PerryXu1/optical-power-meter/Block Diagram/opm-block-diagram.png

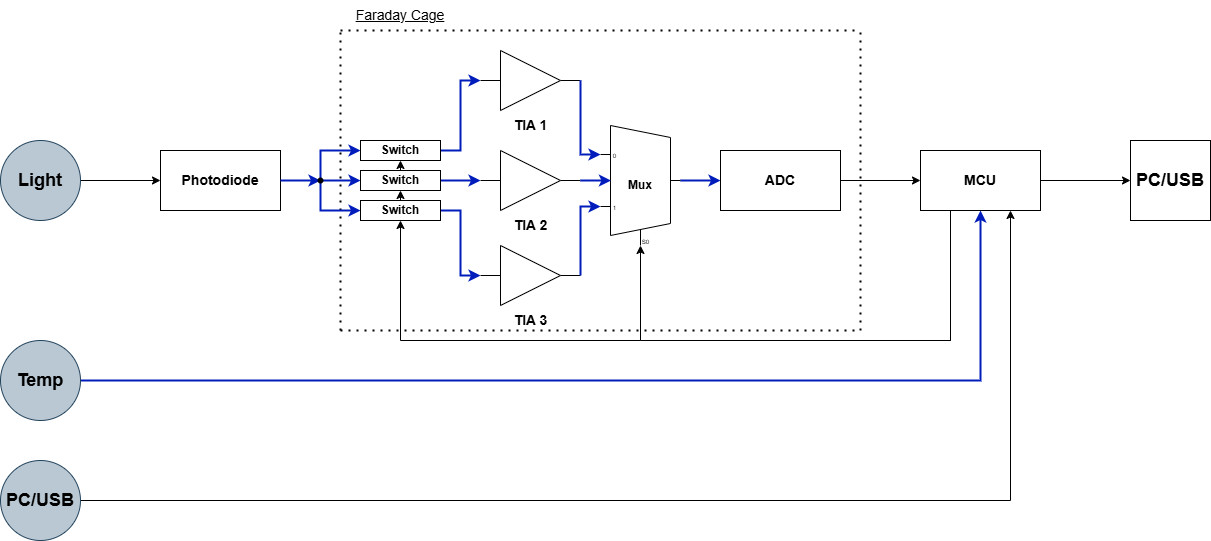
Block Diagram/opm-block-diagram.png
