PerryXu1/optical-power-meter/Hardware/Components/CC0603JRX7R8BB104/CC0603JRX7R8BB104.step

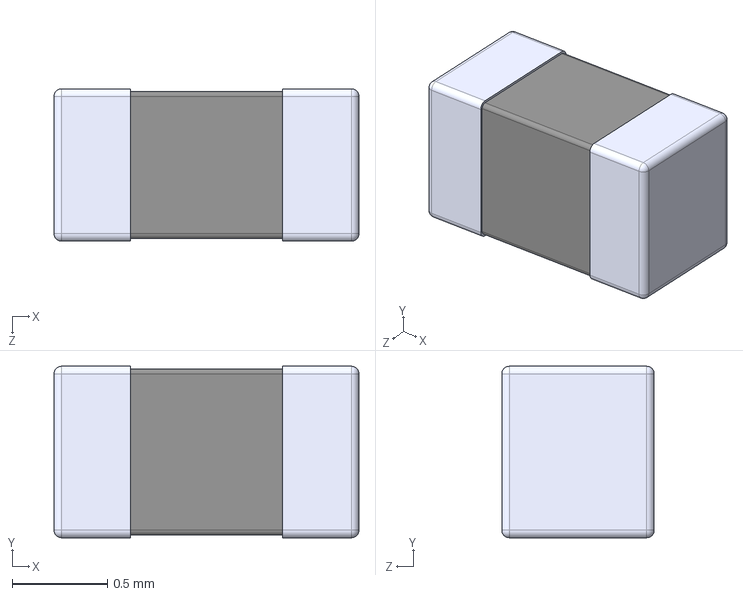
[picture p2: CAD file, 2026-03-04]
Hardware/Components/CC0603JRX7R8BB104/CC0603JRX7R8BB104.step
1.60 x 0.9 x 0.8 mm
