PerryXu1/optical-power-meter/Hardware/Components/CC0805KKX7R7BB106/Altium/CAP_CC0805_YAG.step

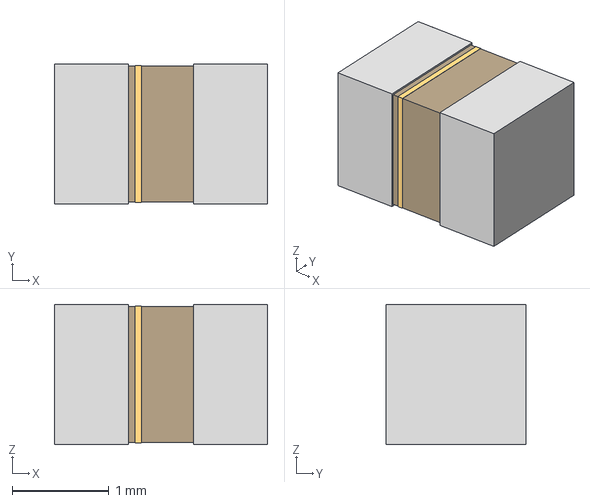
[picture p3: CAD file, 2026-03-04]
Hardware/Components/CC0805KKX7R7BB106/Altium/CAP_CC0805_YAG.step
2.20 x 1.45 x 1.45 mm
