PerryXu1/optical-power-meter/Hardware/Components/CRCW08051M00FKEA/CRCW08051M00FKEA.STEP

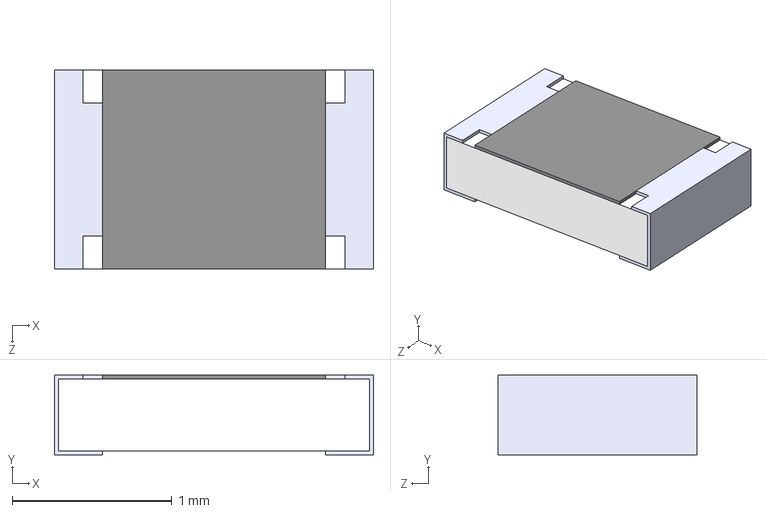
[picture p4: CAD file, 2026-03-12]
Hardware/Components/CRCW08051M00FKEA/CRCW08051M00FKEA.STEP
2.00 x 0.5 x 1.25 mm
