PerryXu1/optical-power-meter/Hardware/Components/LIB_104JT-025/104JT-025/3D/104JT-025.stp

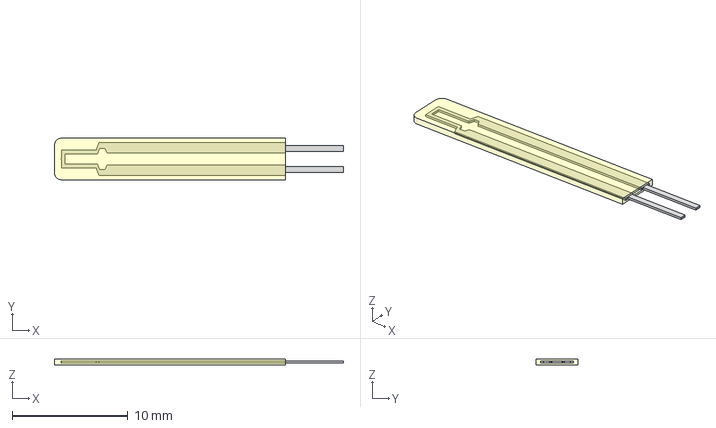
[picture p5: CAD file, 2026-03-04]
Hardware/Components/LIB_104JT-025/104JT-025/3D/104JT-025.stp
25.0 x 3.60 x 0.5 mm
