PerryXu1/optical-power-meter/Hardware/Components/OPA392DBVR/Altium/OPA392DBVR/SOT-23-5_DBV_TEX.step

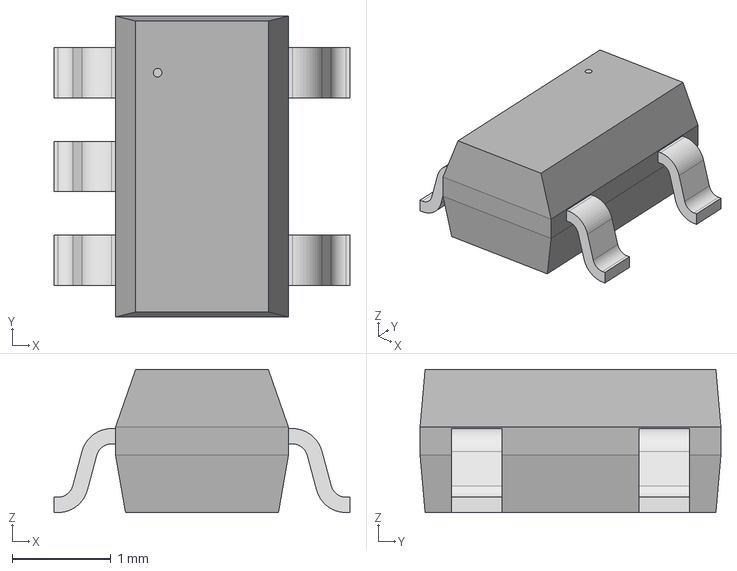
[picture p6: CAD file, 2026-03-04]
Hardware/Components/OPA392DBVR/Altium/OPA392DBVR/SOT-23-5_DBV_TEX.step
3.00 x 3.05 x 1.45 mm
