PerryXu1/optical-power-meter/Hardware/Components/OPA392DBVR/DBV0005A.stp

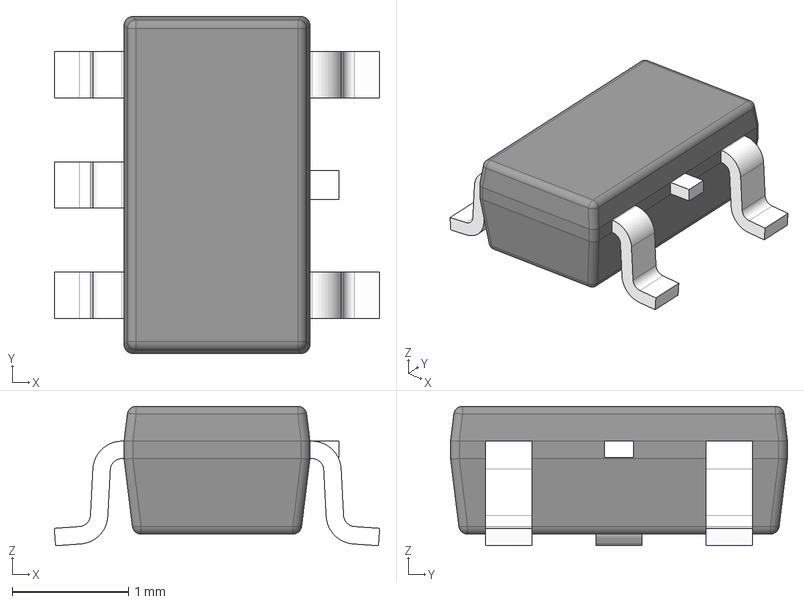
[picture p7: CAD file, 2026-03-04]
Hardware/Components/OPA392DBVR/DBV0005A.stp
2.80 x 2.90 x 1.20 mm
BODY-SOT
LEAD-SOT x 5
LEAD-DUMMY
