PerryXu1/optical-power-meter/Hardware/Components/SS12/SS12.STEP

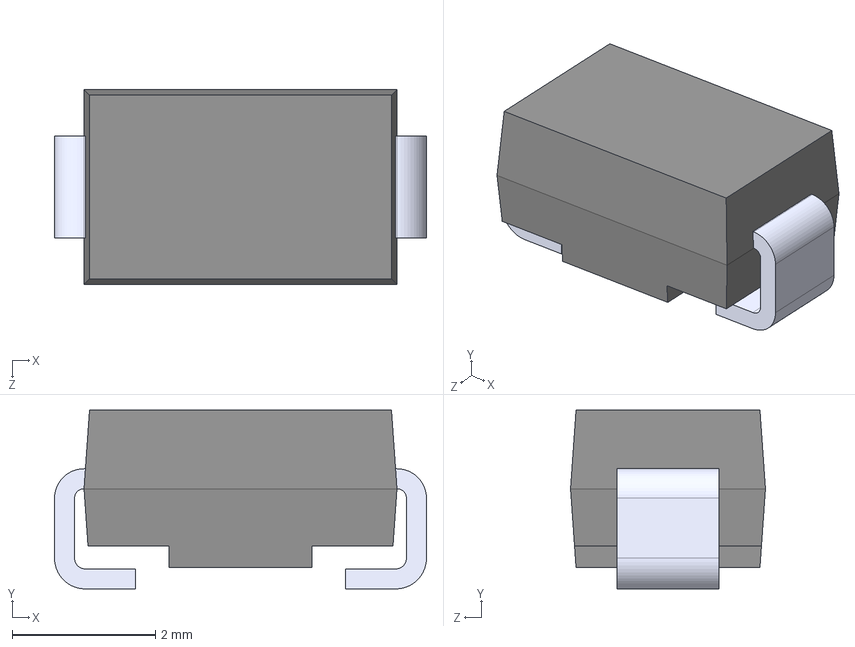
[picture p8: CAD file, 2026-03-04]
Hardware/Components/SS12/SS12.STEP
5.20 x 2.50 x 2.72 mm
