PerryXu1/optical-power-meter/Hardware/Components/TMUX1119DBVR/DBV0006A.stp

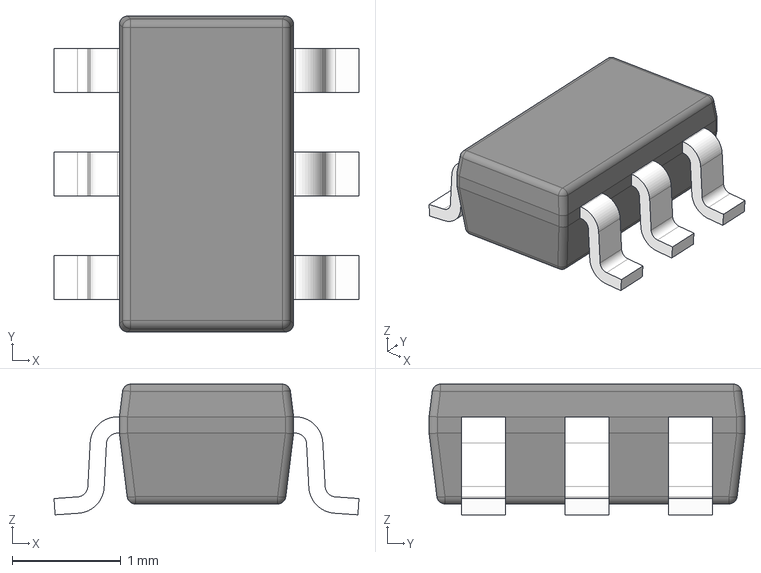
[picture p9: CAD file, 2026-03-04]
Hardware/Components/TMUX1119DBVR/DBV0006A.stp
2.80 x 2.90 x 1.20 mm
BODY-SOT
LEAD-SOT x 6
