PerryXu1/optical-power-meter/Hardware/Components/TNPW0603100KBXEN/TNPW0603100KBXEN.STEP

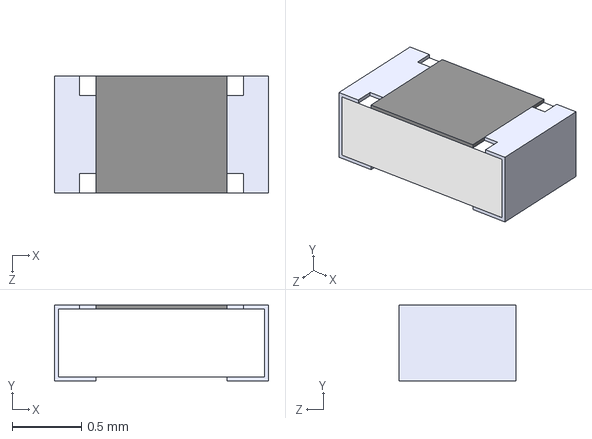
[picture p10: CAD file, 2026-03-04]
Hardware/Components/TNPW0603100KBXEN/TNPW0603100KBXEN.STEP
1.55 x 0.55 x 0.85 mm
