PerryXu1/optical-power-meter/Hardware/Components/TNPW080510K0BXEN/TNPW080510K0BXEN.STEP

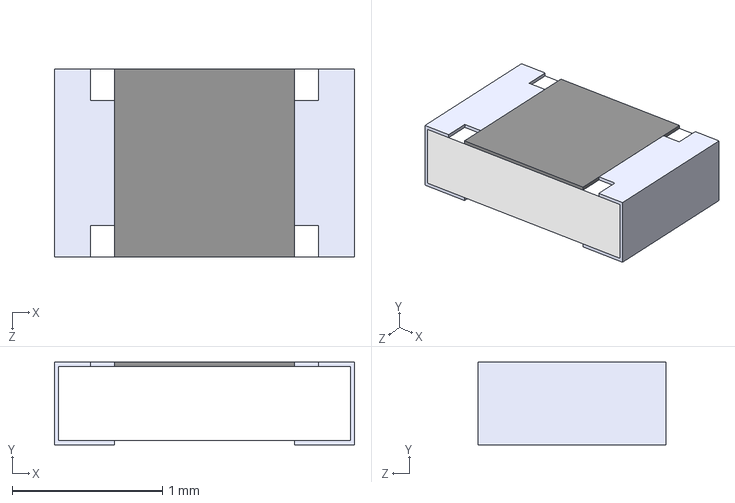
[picture p11: CAD file, 2026-03-04]
Hardware/Components/TNPW080510K0BXEN/TNPW080510K0BXEN.STEP
2.00 x 0.55 x 1.25 mm
