PerryXu1/optical-power-meter/Hardware/Components/VBPW34S/VBPW34S.STEP

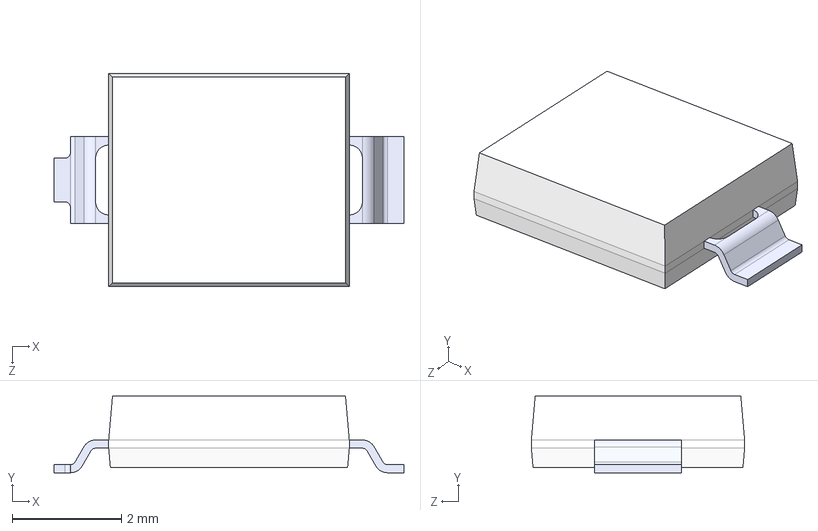
[picture p12: CAD file, 2026-03-04]
Hardware/Components/VBPW34S/VBPW34S.STEP
6.40 x 1.40 x 3.90 mm
