PerryXu1/optical-power-meter/Hardware/Components/VJ1206Y472KXEAT5Z/VJ1206Y472KXEAT5Z.STEP

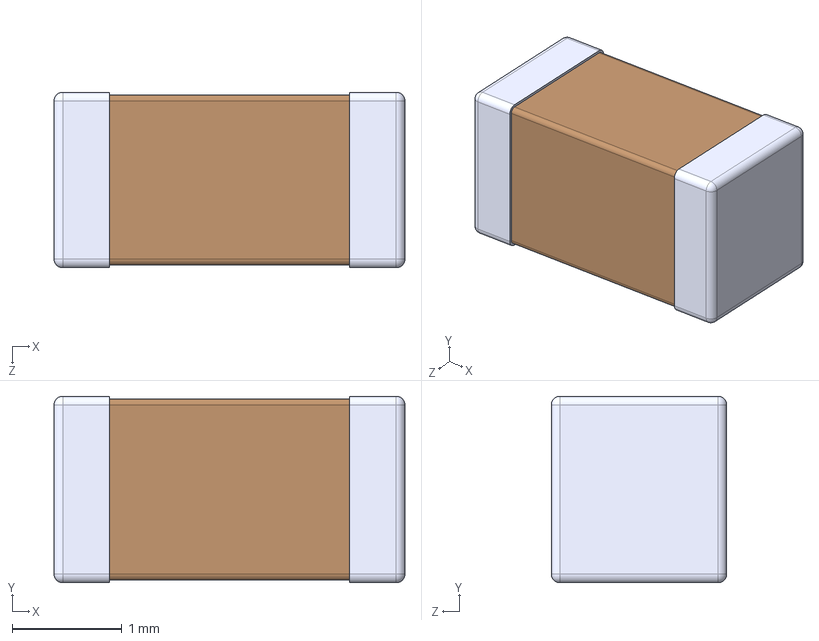
[picture p13: CAD file, 2026-03-12]
Hardware/Components/VJ1206Y472KXEAT5Z/VJ1206Y472KXEAT5Z.STEP
3.20 x 1.70 x 1.60 mm
