PerryXu1/optical-power-meter/Hardware/Components/MCP73831T_2ACI_OT/MCP73831T-2ACI_OT.STEP

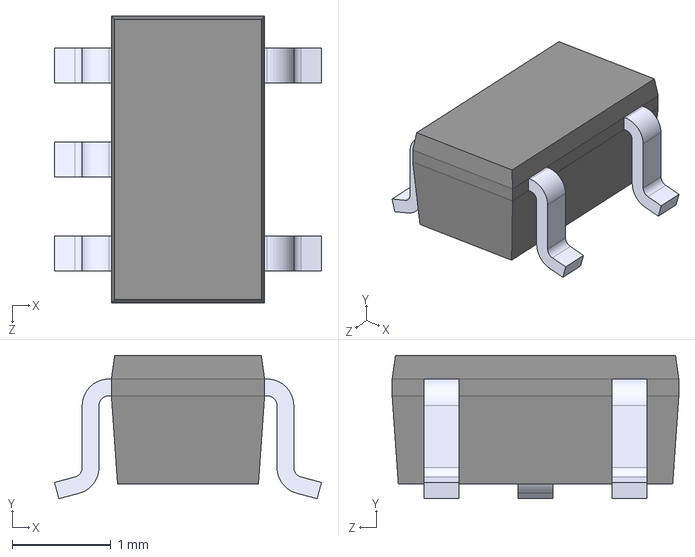
[picture p15: CAD file, 2026-03-04]
Hardware/Components/MCP73831T_2ACI_OT/MCP73831T-2ACI_OT.STEP
2.70 x 1.45 x 2.90 mm
