PerryXu1/optical-power-meter/(list of files, cad)

Other CAD files:
Hardware/Components/CC0805KKX7R7BB106/CAP_CC0805_YAG.step
Hardware/Components/TMUX1119DBVR/Altium/TMUX1119DBVR/SOT-23-6_DBV_TEX.step
Hardware/Components/LIB_104JT-025/104JT-025/Allegro/104jt025.psm
Hardware/Components/LIB_104JT-025/104JT-025/DEHDL/104jt_025/chips/chips.prt
