PerryXu1/optical-power-meter/Hardware/opm/opm.pdf

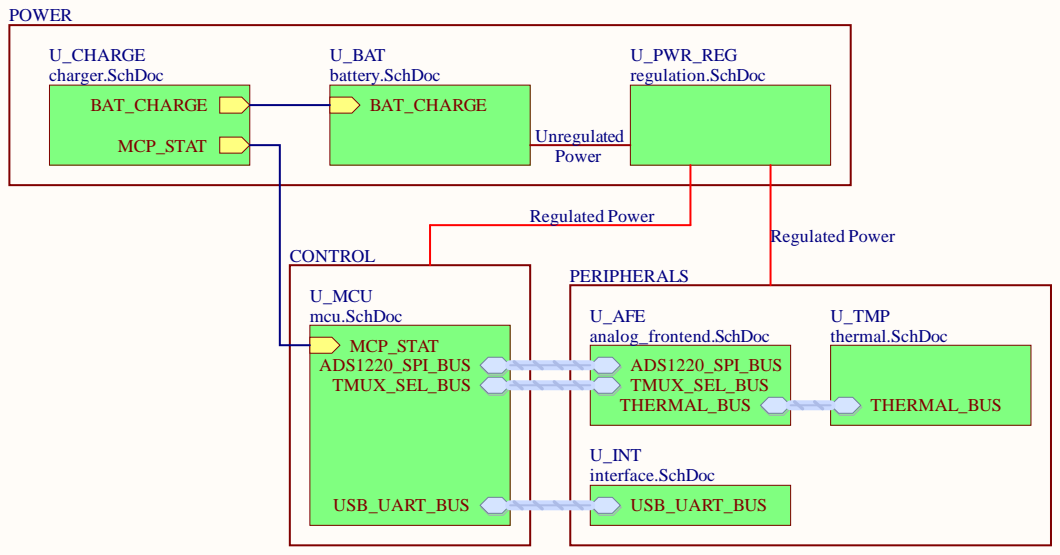
[picture p27: page 1]

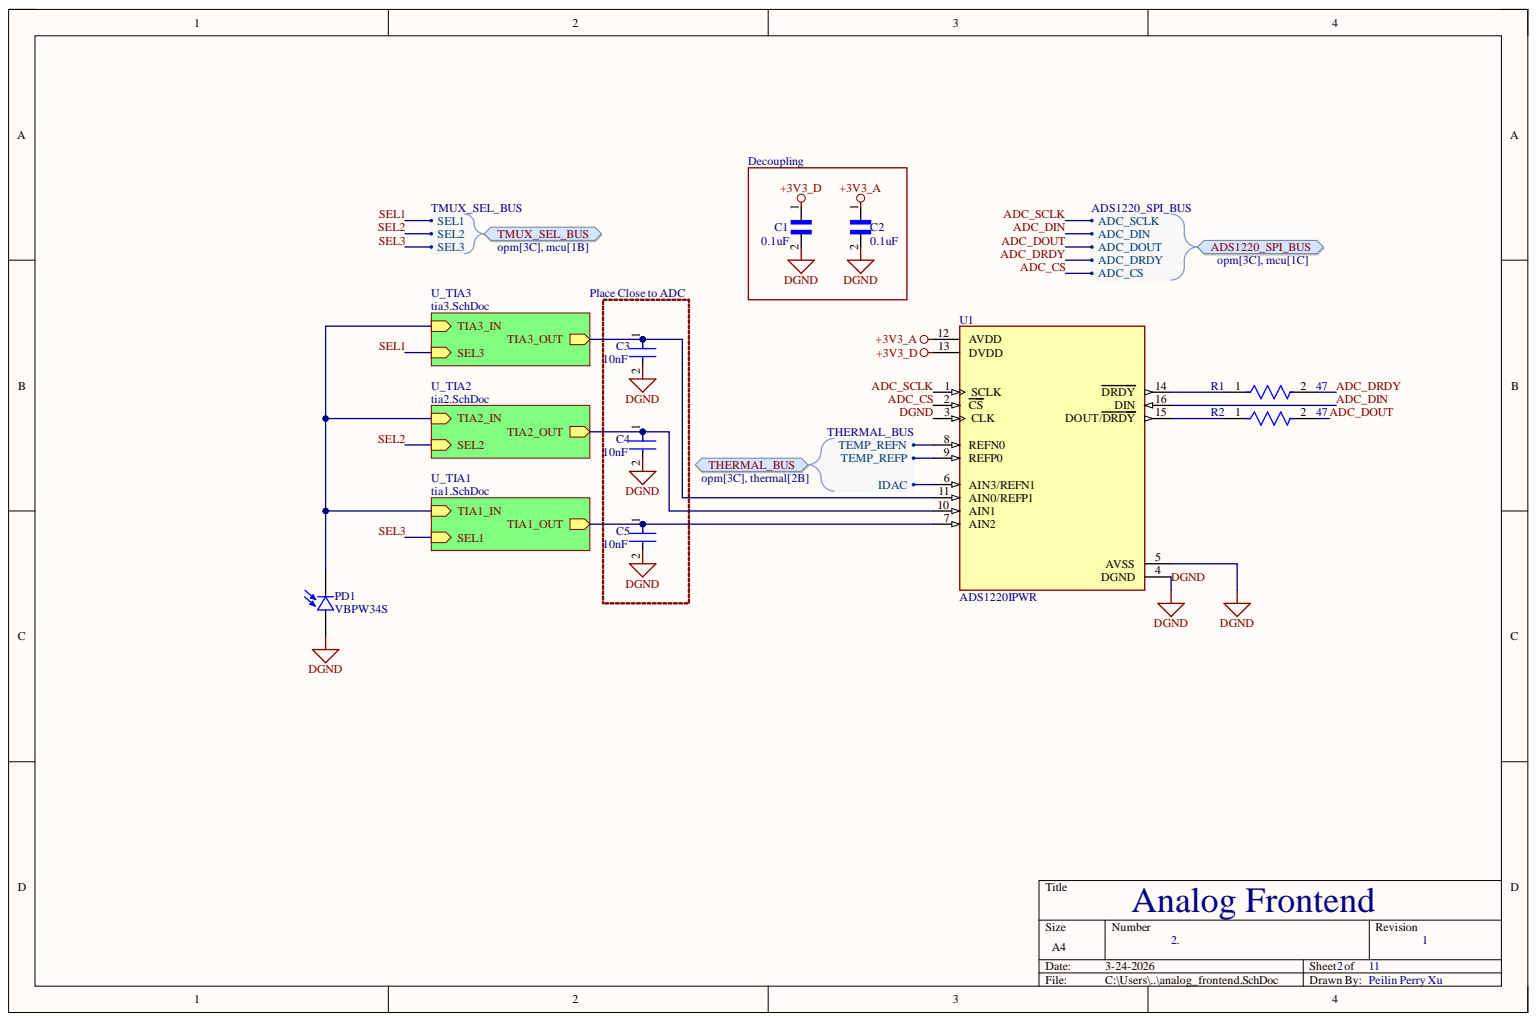
[picture p28: page 2]

Place Close to ADC

DGND | TEMP_REFN opm[3C], thermal[2B] IDAC

TIA1_IN TIA1_OUT SEL1 | | AIN1 10

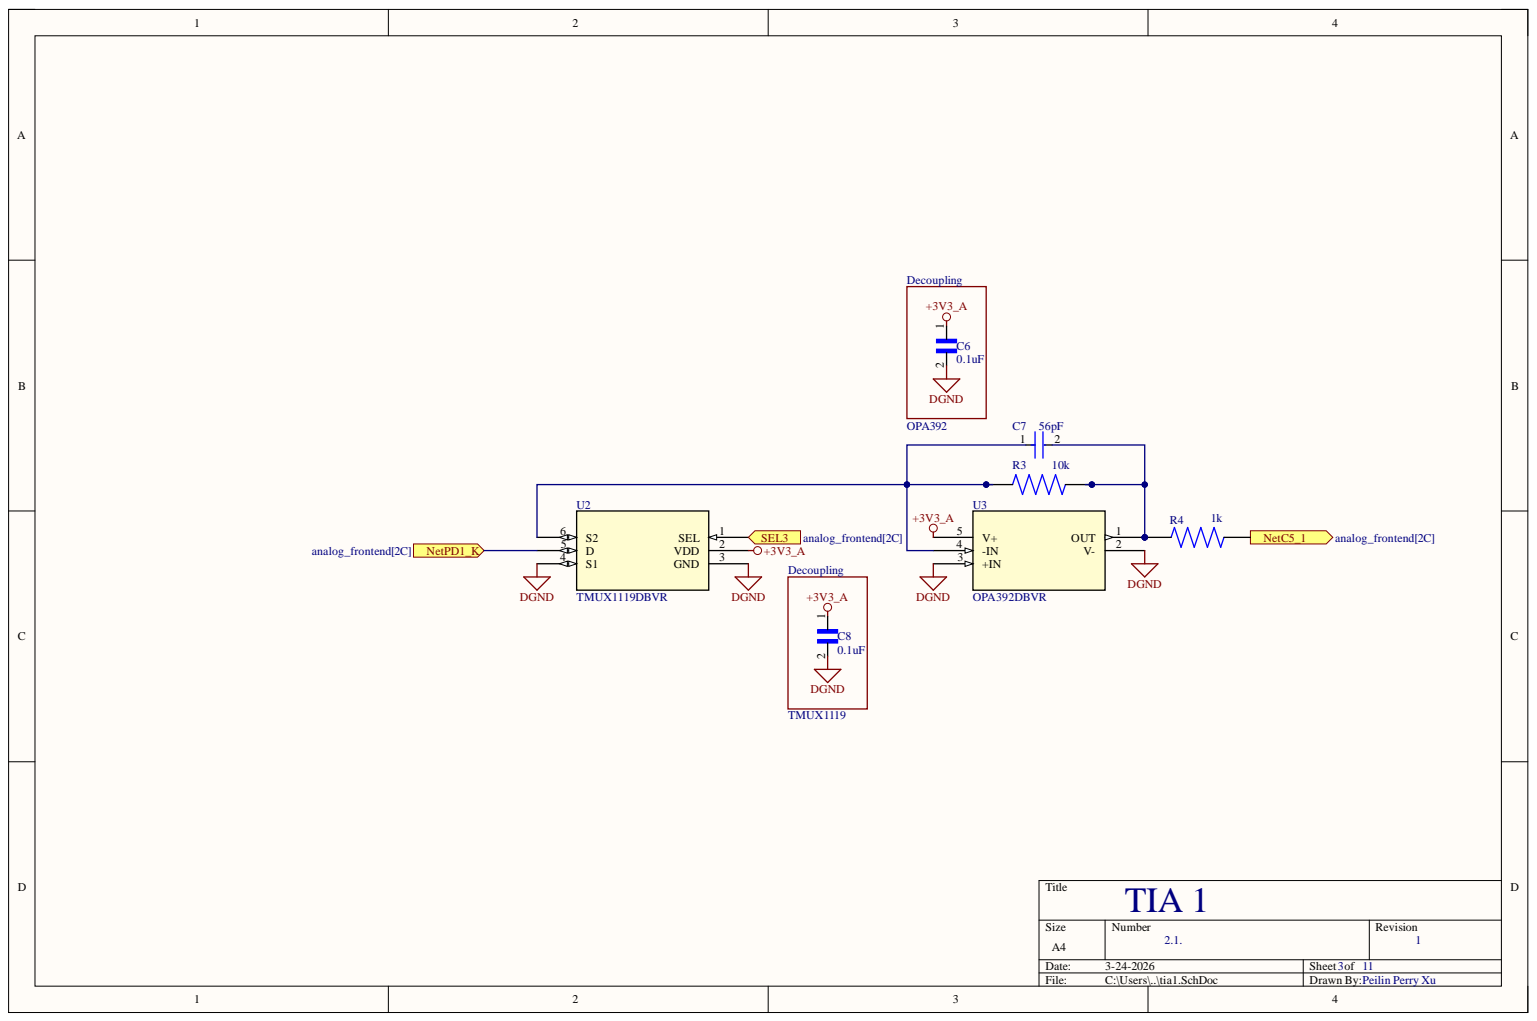
[picture p29: page 3]

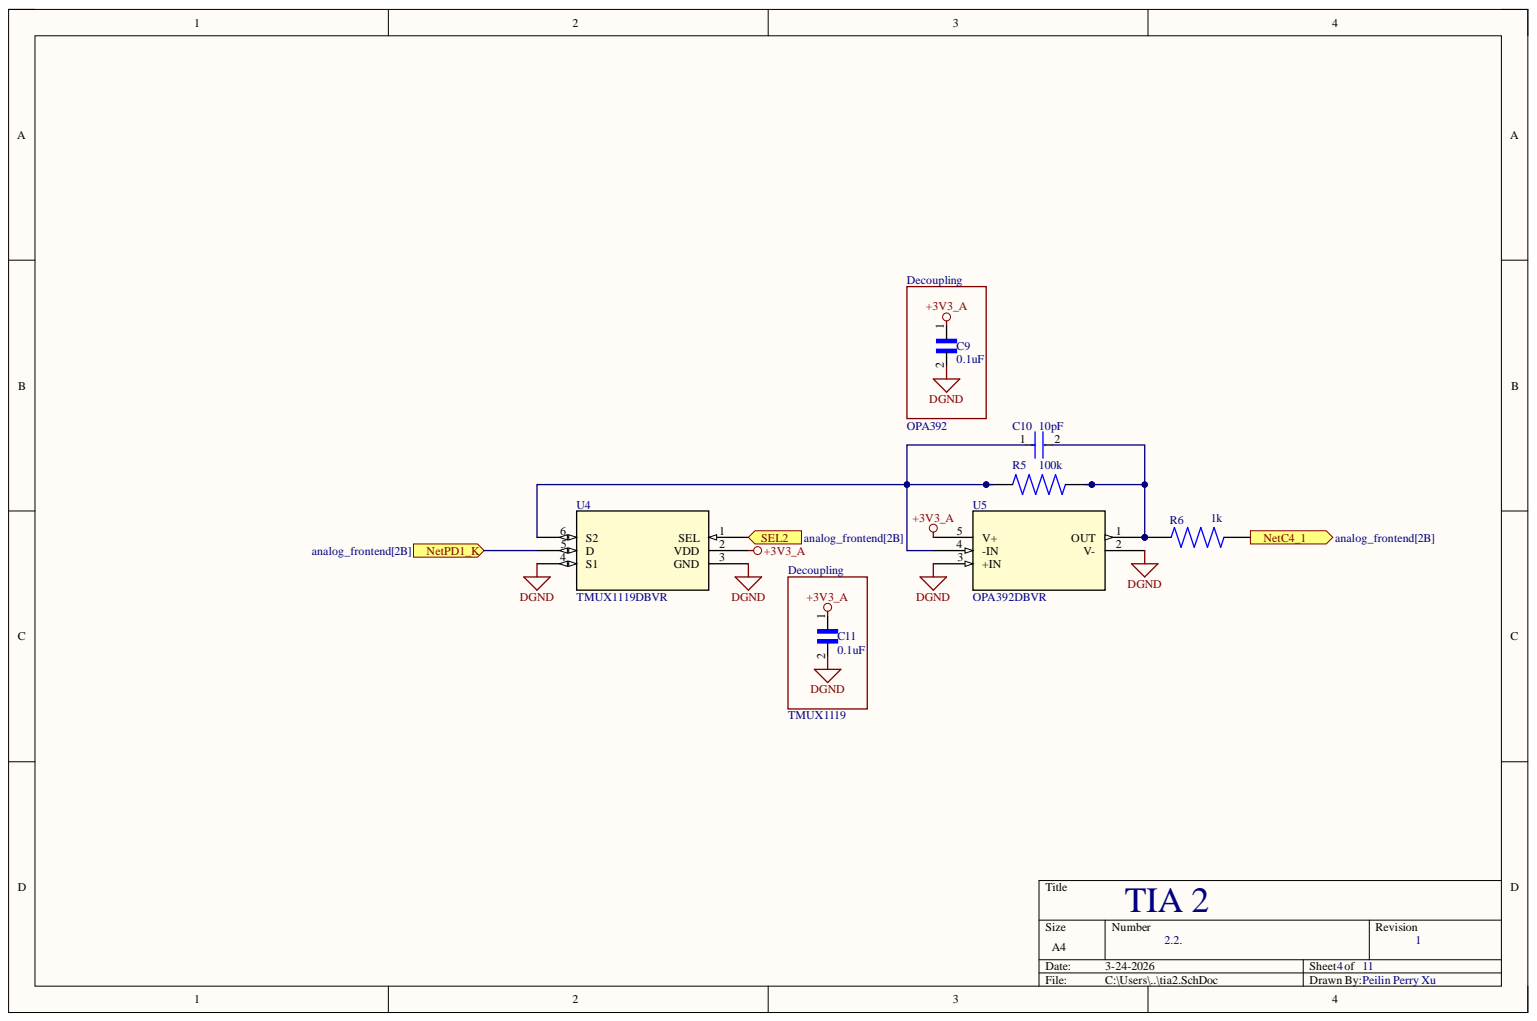
[picture p30: page 4]

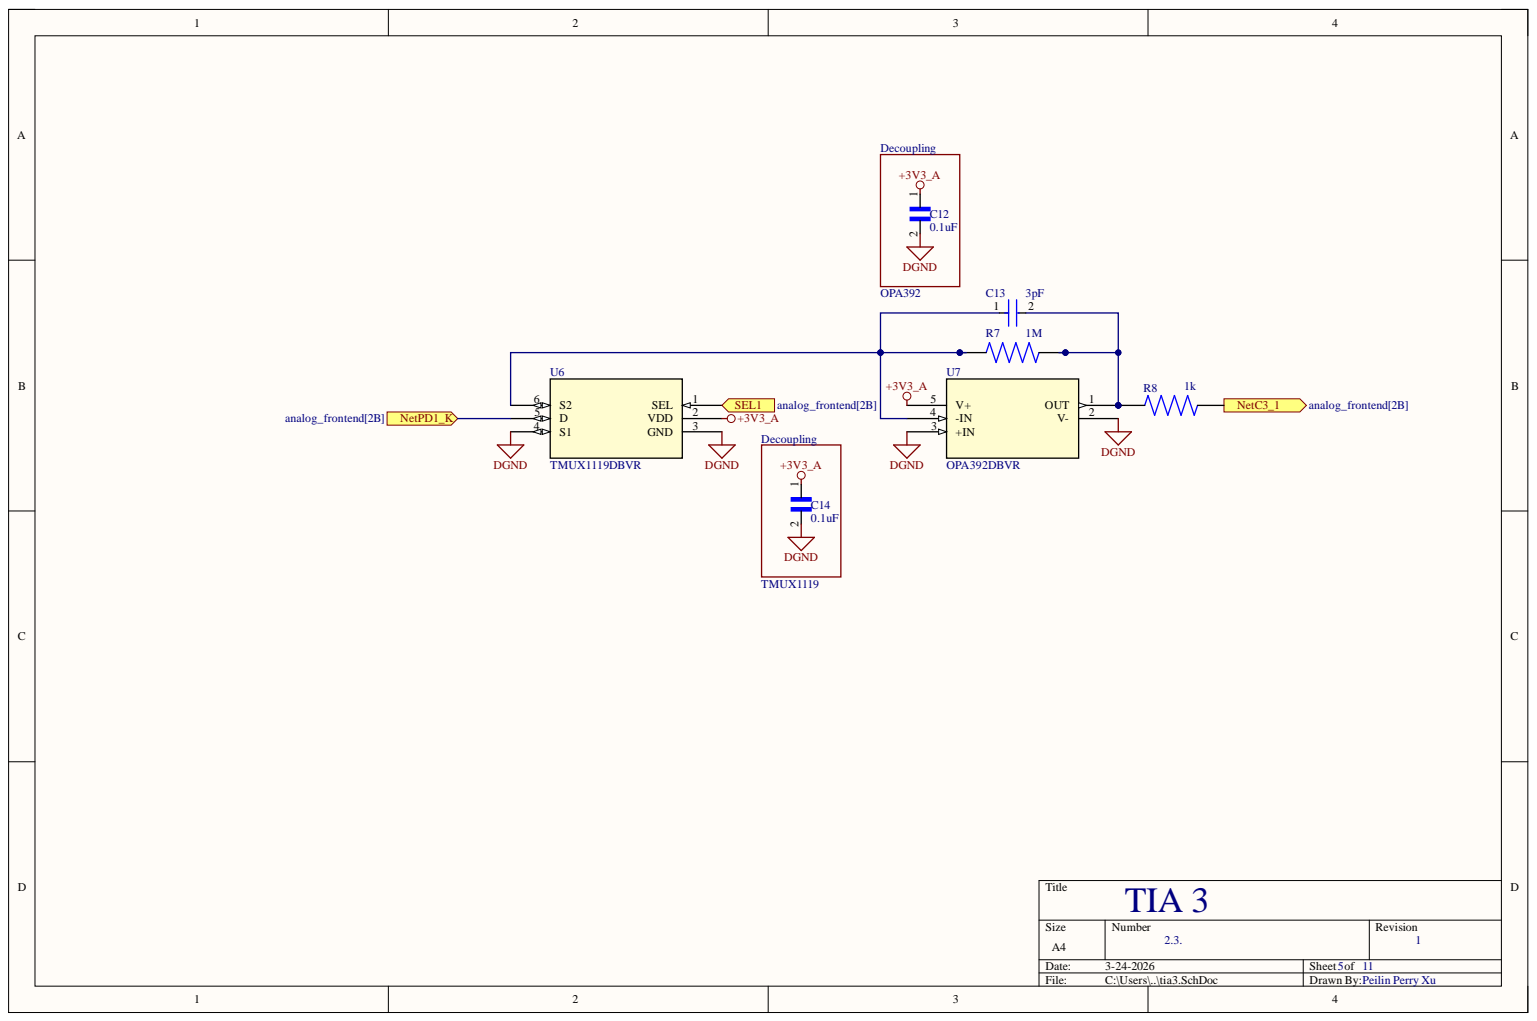
[picture p31: page 5]

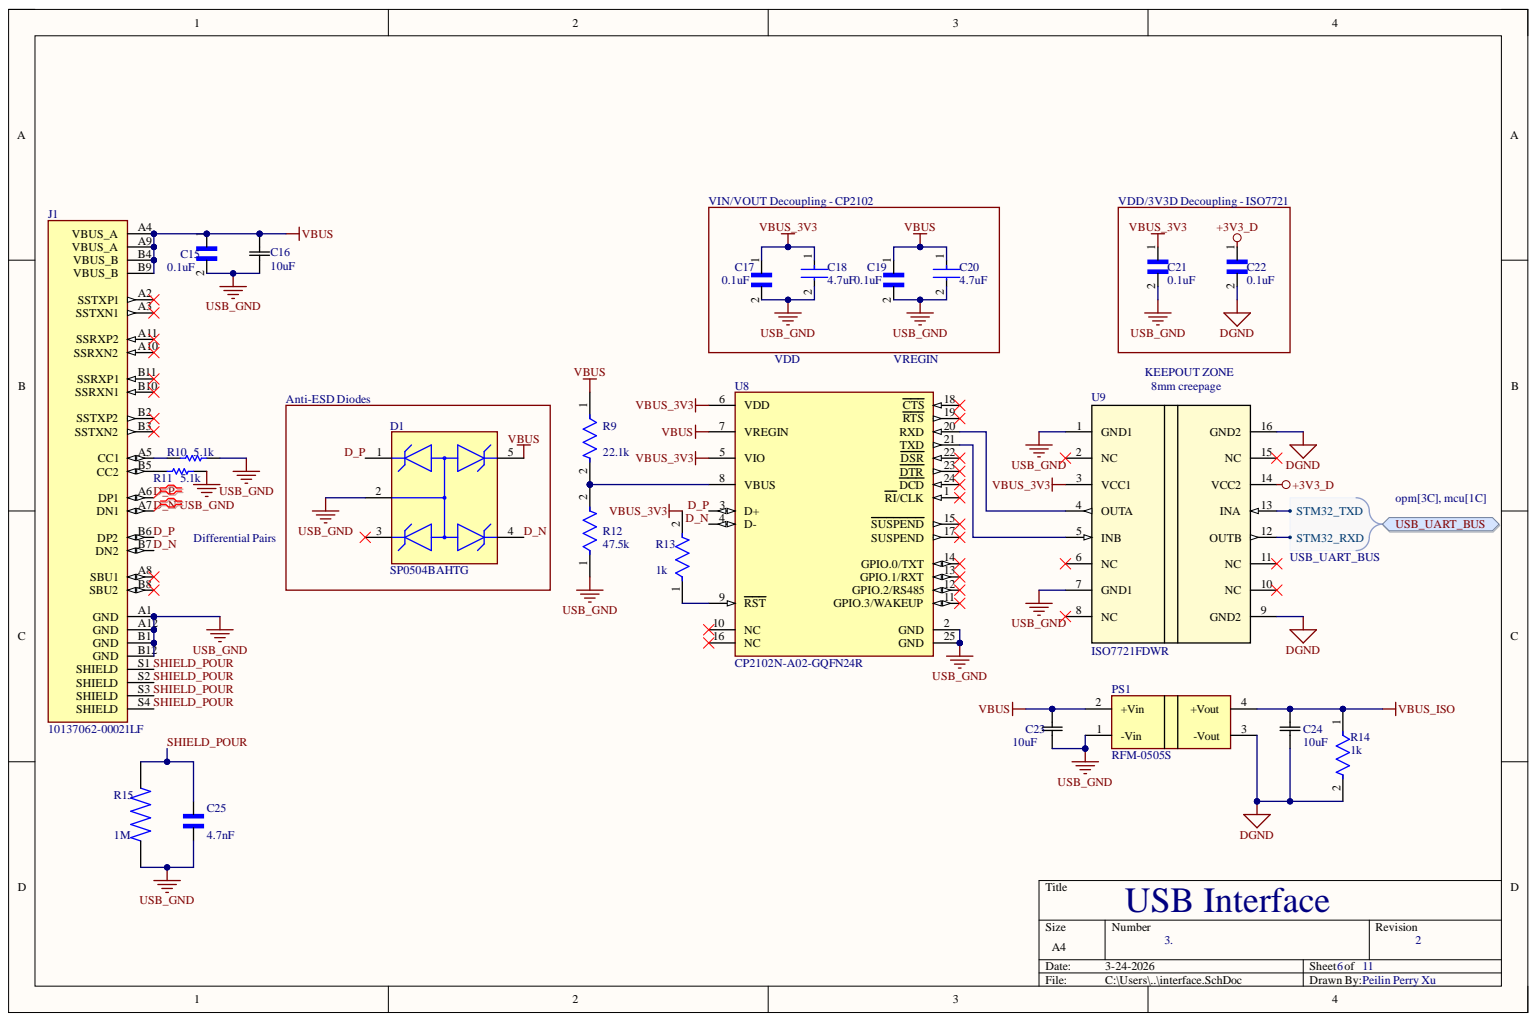
[picture p32: page 6]

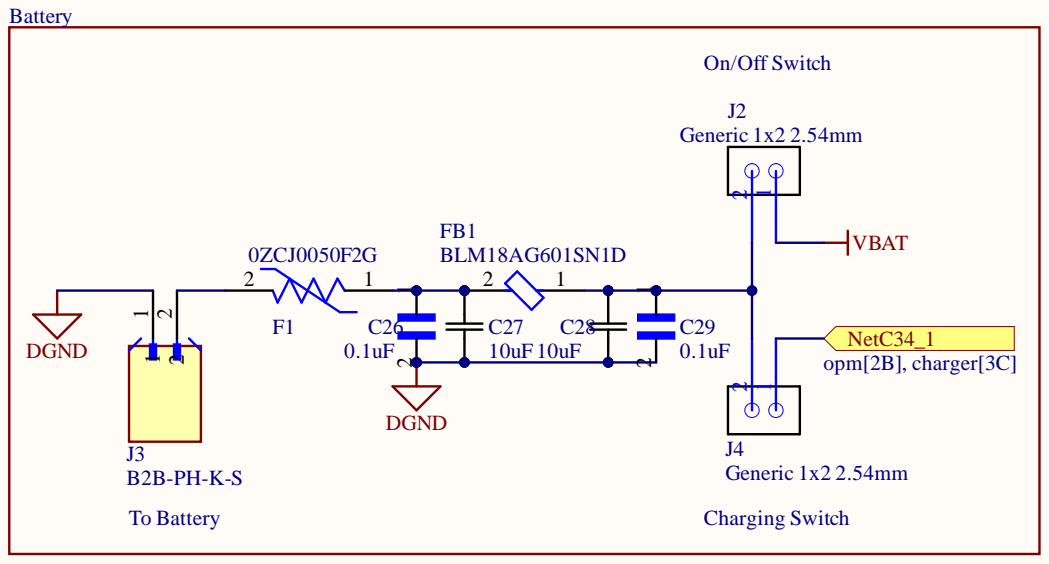
[picture p33: page 7]

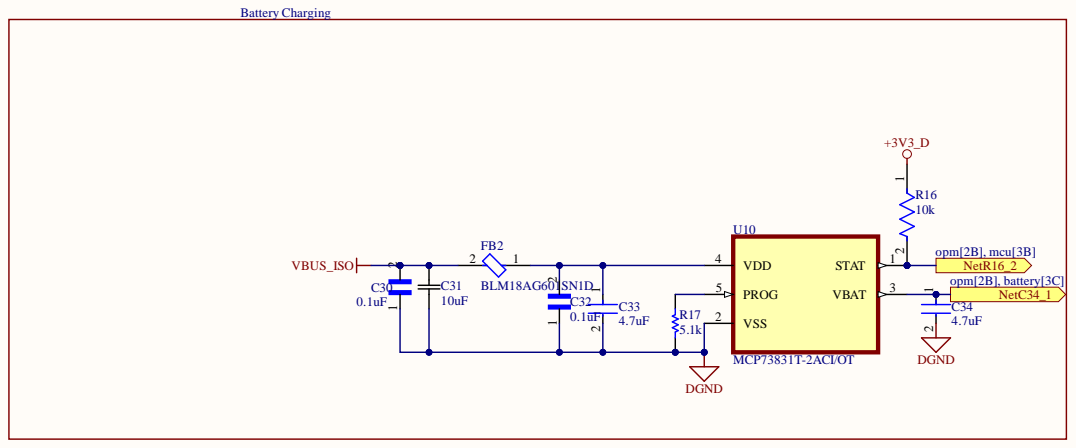
[picture p34: page 8]

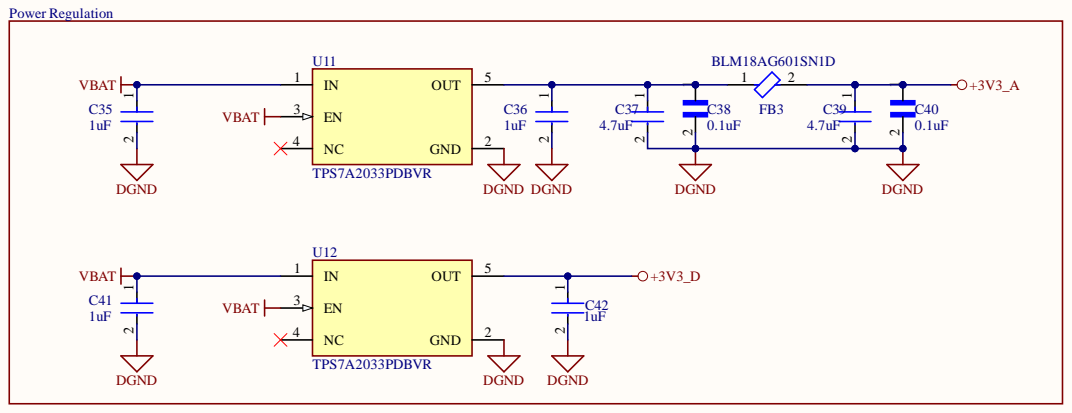
[picture p35: page 9]

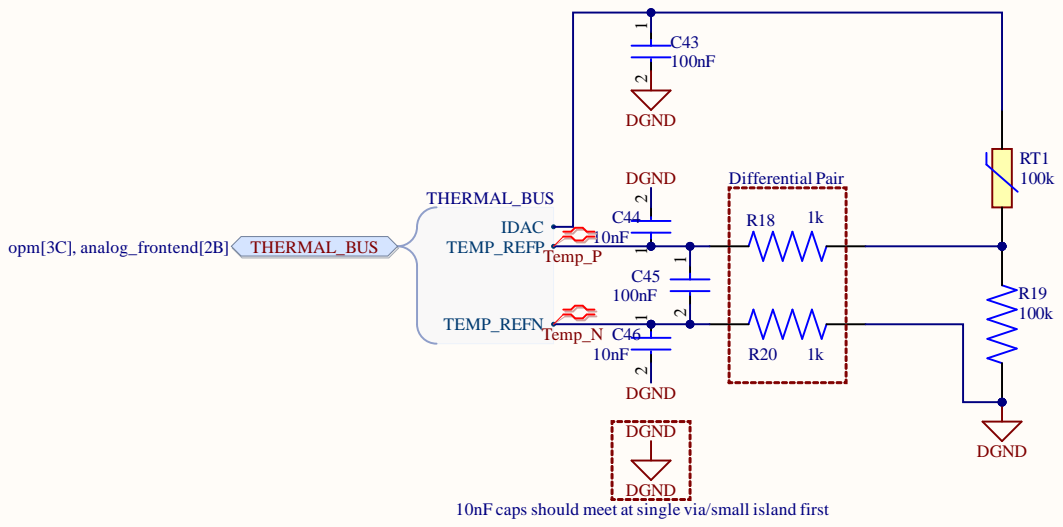
[picture p36: page 10]

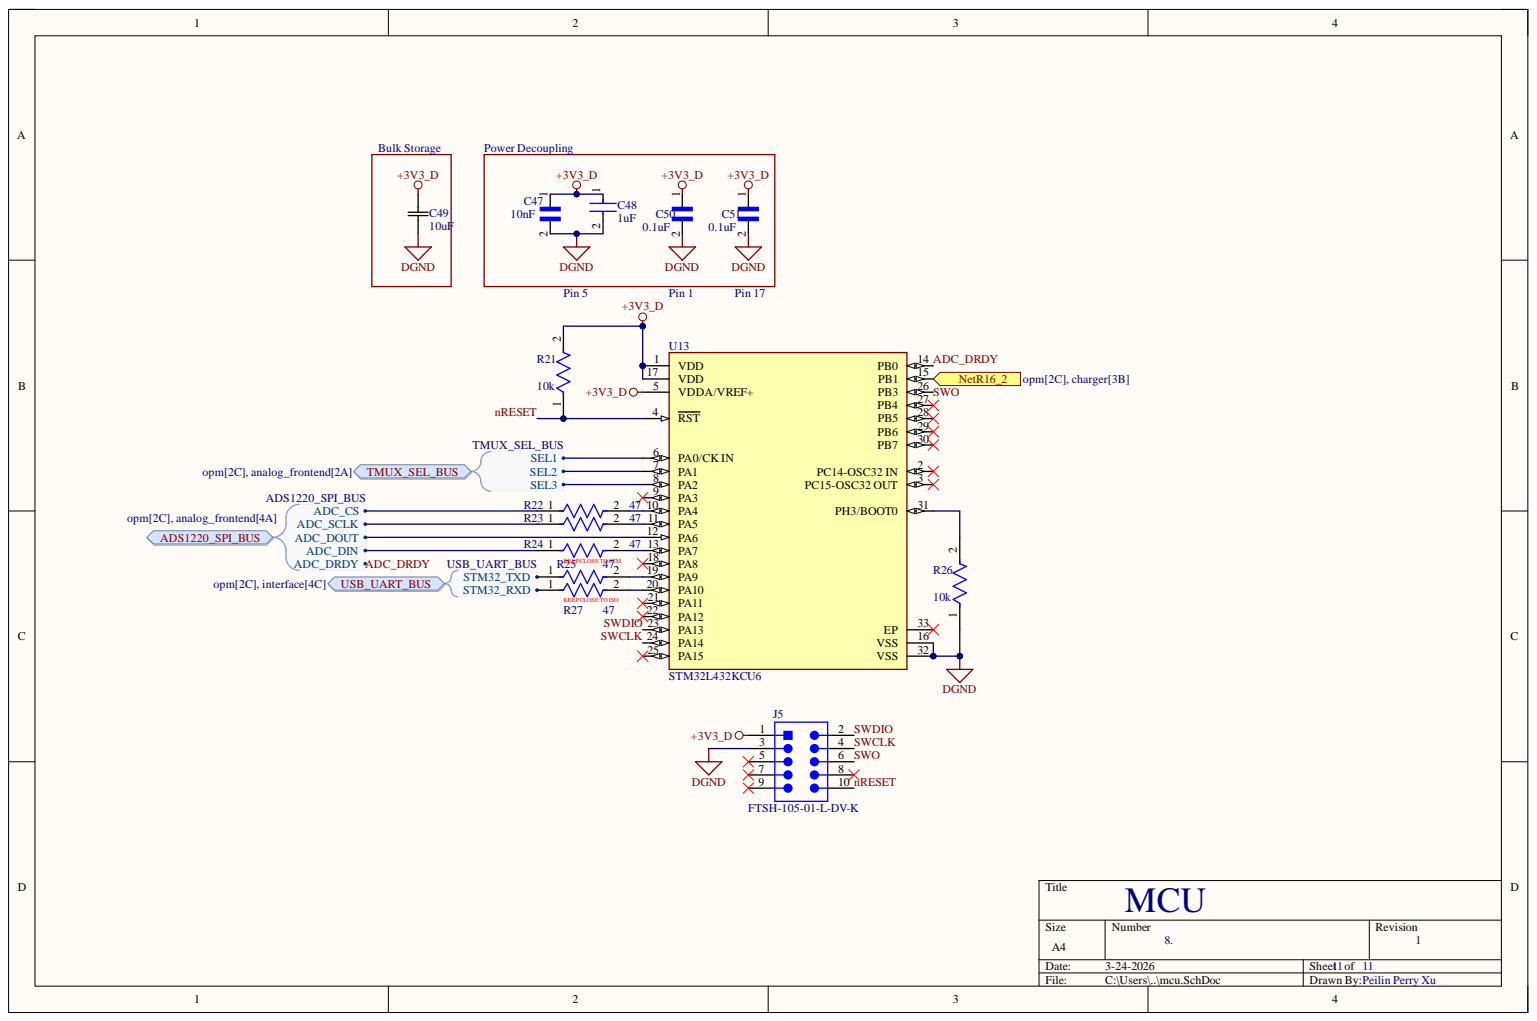
[picture p37: page 11]
