PerryXu1/optical-power-meter/Simulation/Draft1.asc

F1: f; 1
I1: current; 15
R1: Res; 2
R2: Res; 12
V1: Voltage; 0
Named nets: 0
.op
