PerryXu1/optical-power-meter/Simulation/opm-simulation.asc

B1: bv; V = int(((PATH==1)*V(MUX1) + (PATH==2)*V(MUX2) + (PATH==3)*V(MUX3) + k*(V(MUX1)+V(MUX2)+V(MUX3)) ) * 16777215 / 5 + 0.5) * (5 / 16777215)
C1: Cap; 70pF
C2: Cap; Q=V(DEMUX1,0) * (PATH==1 ? {Con} : {Coff})
C3: Cap; Q=V(DEMUX2,0) * (PATH==2 ? {Con} : {Coff})
C4: Cap; Q=V(DEMUX3,0) * (PATH==3 ? {Con} : {Coff})
C5: Cap; Q=V(MUX1,0) * (PATH==1 ? {Cmon} : {Cmoff})
C6: Cap; Q=V(MUX2,0) * (PATH==2 ? {Cmon} : {Cmoff})
C7: Cap; Q=V(MUX3,0) * (PATH==3 ? {Cmon} : {Cmoff})
C8: Cap; {Cbus}
C9: Cap; {Cf}
C10: Cap; {Cf}
C11: Cap; {Cf}
I1: current; PULSE(10n 30u 0 1u 1u 1m 2m)
I2: current; {Idleak}
I3: current; {Idleak}
I4: current; {Idleak}
I5: current; {Imleak}
I6: current; {Imleak}
I7: current; {Imleak}
R1: Res; R=PATH==1 ? {Rdon} : {Roff}
R2: Res; R=PATH==2 ?{Rdon} : {Roff}
R3: Res; R=PATH==3 ? {Rdon} : {Roff}
R4: Res; R=PATH==1 ? {Rmon} : {Roff}
R5: Res; R=PATH==2 ? {Rmon} : {Roff}
R6: Res; R=PATH==3 ? {Rmon} : {Roff}
R7: Res; {Rf}
R8: Res; {Rf}
R9: Res; {Rf}
V1: voltage; 5
X1: tia; Rf=10k Cf=56p
X2: tia; Rf=100k Cf=11p
X3: tia; Rf=1Meg Cf=3.1pF
Named nets: 0, Output, 5V, DEMUX1, DEMUX2, DEMUX3, MUX1, MUX3, MUX2
.noise V(MUX1) I1 oct 10 0.1 100
.options plotwinsize=0
* --- Constants ---
.param Rmon = 85
.param Roff = 1G
.param Rdon = 2.5k
.param Con = 5p
.param Coff = 2p
.param Cmon = 15p
.param Cmoff = 2p
.param Cbus = 15p
.param Imleak = 10p
.param Idleak= 1p
.param k = 1e-7
.param Rf 1k
.param Cf 10n
* --- Selection Logic ---
.param PATH = 1
* .step param PATH list 1 2 3
DEMUX
MUX
Filter
