PerryXu1/optical-power-meter/Simulation/tia.asc

C1: Cap; {Cf}
R1: Res; {Rf}
U1: AD8605
Named nets: -, +, out, GND, VCC
.subckt tia 1 2 3 4 5
.ends tia
