PerryXu1/optical-power-meter/(list of files, drawings)

Other design files:
Hardware/Components/0ZCJ0050FF2G/0ZCJ0050FF2G.PcbLib
Hardware/Components/0ZCJ0050FF2G/0ZCJ0050FF2G.SchLib
Hardware/Components/0ZCJ0050FF2G/0ZCJ0050FF2G/0ZCJ0050FF2G.PcbLib
Hardware/Components/0ZCJ0050FF2G/0ZCJ0050FF2G/0ZCJ0050FF2G.SchLib
Hardware/Components/10137062_00021LF/10137062-00021LF/10137062-00021LF.SchLib
Hardware/Components/10137062_00021LF/10137062-00021LF/AMPHENOL_10137062-00021LF.PcbLib
Hardware/Components/ADS1220IPWR/ADS1220IPWR/ADS1220IPWR.SchLib
Hardware/Components/ADS1220IPWR/ADS1220IPWR/SOP65P640X120-16N.PcbLib
Hardware/Components/B2B_PH_K_S/B2B-PH-K-S/B2B-PH-K-S.SchLib
Hardware/Components/B2B_PH_K_S/B2B-PH-K-S/JST_B2B-PH-K-S.PcbLib
Hardware/Components/BLM18AG601SN1D/BLM18AG601SN1D.PcbLib
Hardware/Components/BLM18AG601SN1D/BLM18AG601SN1D.SchLib
Hardware/Components/BLM18AG601SN1D/BLM18AG601SN1D/Components - 25.02.26 - 18.26.PcbLib
Hardware/Components/BLM18AG601SN1D/BLM18AG601SN1D/Components - 25.02.26 - 18.26.SchLib
Hardware/Components/CC0603JRX7R8BB104/CC0603JRX7R8BB104/CAPC1608X90.PcbLib
Hardware/Components/CC0603JRX7R8BB104/CC0603JRX7R8BB104/CC0603JRX7R8BB104.SchLib
Hardware/Components/CC0805KKX7R7BB106/Altium/CC0805KKX7R7BB106.PcbLib
Hardware/Components/CC0805KKX7R7BB106/Altium/CC0805KKX7R7BB106.SchLib
Hardware/Components/CC0805KKX7R7BB475/CC0805KKX7R7BB475.PcbLib
Hardware/Components/CC0805KKX7R7BB475/CC0805KKX7R7BB475.SchLib
Hardware/Components/CC0805KKX7R7BB475/CC0805KKX7R7BB475/CC0805KKX7R7BB475.PcbLib
Hardware/Components/CC0805KKX7R7BB475/CC0805KKX7R7BB475/CC0805KKX7R7BB475.SchLib
Hardware/Components/CP2102N-A02-GQFN24R/CP2102N-A02-GQFN24R.PcbLib
Hardware/Components/CP2102N-A02-GQFN24R/CP2102N-A02-GQFN24R.SchLib
Hardware/Components/CP2102N-A02-GQFN24R/CP2102N-A02-GQFN24R/CP2102N-A02-GQFN24R.PcbLib
Hardware/Components/CP2102N-A02-GQFN24R/CP2102N-A02-GQFN24R/CP2102N-A02-GQFN24R.SchLib
Hardware/Components/CRCW08051M00FKEA/CRCW08051M00FKEA/CRCW08051M00FKEA.SchLib
Hardware/Components/CRCW08051M00FKEA/CRCW08051M00FKEA/RESC2012X50N.PcbLib
Hardware/Components/FTSH-105-01-L-DV-K/FTSH-105-01-L-DV-K.PcbLib
Hardware/Components/FTSH-105-01-L-DV-K/FTSH-105-01-L-DV-K.SchLib
Hardware/Components/FTSH-105-01-L-DV-K/FTSH-105-01-L-DV-K/FTSH-105-01-L-DV-K.PcbLib
Hardware/Components/FTSH-105-01-L-DV-K/FTSH-105-01-L-DV-K/FTSH-105-01-L-DV-K.SchLib
Hardware/Components/GCM1885C2A100JA16D/GCM1885C2A100JA16D.PcbLib
Hardware/Components/GCM1885C2A100JA16D/GCM1885C2A100JA16D.SchLib
Hardware/Components/GCM1885C2A100JA16D/GCM1885C2A100JA16D/GCM1885C2A100JA16D.PcbLib
Hardware/Components/GCM1885C2A100JA16D/GCM1885C2A100JA16D/GCM1885C2A100JA16D.SchLib
Hardware/Components/GCM1885C2A560JA16D/GCM1885C2A560JA16D.PcbLib
Hardware/Components/GCM1885C2A560JA16D/GCM1885C2A560JA16D.SchLib
Hardware/Components/GCM1885C2A560JA16D/GCM1885C2A560JA16D/GCM1885C2A560JA16D.PcbLib
Hardware/Components/GCM1885C2A560JA16D/GCM1885C2A560JA16D/GCM1885C2A560JA16D.SchLib
Hardware/Components/GRM21BC71E106KE11L/GRM21BC71E106KE11L.PcbLib
Hardware/Components/GRM21BC71E106KE11L/GRM21BC71E106KE11L.SchLib
Hardware/Components/GRM21BC71E106KE11L/GRM21BC71E106KE11L/GRM21BC71E106KE11L.PcbLib
Hardware/Components/GRM21BC71E106KE11L/GRM21BC71E106KE11L/GRM21BC71E106KE11L.SchLib
Hardware/Components/GRM32ER61A107ME20L/GRM32ER61A107ME20L.PcbLib
Hardware/Components/GRM32ER61A107ME20L/GRM32ER61A107ME20L.SchLib
Hardware/Components/GRM32ER61A107ME20L/GRM32ER61A107ME20L/GRM32ER61A107ME20L.PcbLib
Hardware/Components/GRM32ER61A107ME20L/GRM32ER61A107ME20L/GRM32ER61A107ME20L.SchLib
Hardware/Components/GRM1885C1H103JA01D/GRM1885C1H103JA01D.PcbLib
Hardware/Components/GRM1885C1H103JA01D/GRM1885C1H103JA01D.SchLib
Hardware/Components/GRM1885C1H103JA01D/GRM1885C1H103JA01D/GRM1885C1H103JA01D.PcbLib
Hardware/Components/GRM1885C1H103JA01D/GRM1885C1H103JA01D/GRM1885C1H103JA01D.SchLib
Hardware/Components/GRM3195C1H104JA05D/GRM3195C1H104JA05D.PcbLib
Hardware/Components/GRM3195C1H104JA05D/GRM3195C1H104JA05D.SchLib
Hardware/Components/GRM3195C1H104JA05D/GRM3195C1H104JA05D/GRM3195C1H104JA05D.PcbLib
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
