PerryXu1/optical-power-meter/(commit log)

2026-02-05 feat: create tia symbol and simulate simplified circuit for proof of concept + test for noise robustness
2026-02-12 feat: change block diagram to use 3 separate switches instead of a demux to tie TIAs to ground
2026-02-23 feat: fix simulation + change gitignore to altium
    [PCB1.PcbDoc, PcbLib1.PcbLib, Schlib1.SchLib, Sheet1.SchDoc, opm.PrjPcb]
2026-02-23 feat: simulation changes
    [analog_front_end.kicad_sch, data_conversion.kicad_sch, mcu_digital.kicad_sch, opm.kicad_pcb, opm.kicad_sch, power_supply.kicad_sch, usb_interface.kicad_sch]
2026-03-04 feat: add relevant schematics/footprints/models to design
    [0ZCJ0050FF2G.PcbLib, 0ZCJ0050FF2G.SchLib, 10137062-00021LF.SchLib, 104JT-025.SchLib, 104JT-025.stp, 104JT025.PcbLib, 104jt025.psm, ADS1220IPWR.SchLib]
2026-03-06 feat: preliminary design for analog front end
    [OPM.SchDoc, analog_frontend.SchDoc, tia1.SchDoc, tia2.SchDoc, tia3.SchDoc]
2026-03-06 feat: prelim design for power management subsystem
    [CC0805KKX7R7BB475.PcbLib, CC0805KKX7R7BB475.SchLib, OPM.SchDoc, RC0603FR-075K1L.PcbLib, RC0603FR-075K1L.SchLib, opm_lib.PcbLib, opm_lib.SchLib, power_mgmt.SchDoc]
2026-03-06 feat: prelim design for power management
    [opm.PrjPcb, power_mgmt.SchDoc]
2026-03-06 feat: add harness for tmux selection bus
    [analog_frontend.SchDoc, tia1.SchDoc, tia2.SchDoc, tia3.SchDoc]
2026-03-07 feat: prelim design for usb interface
    [CAPC3216X170N.PcbLib, CRCW08051M00FKEA.STEP, CRCW08051M00FKEA.SchLib, DW0016B.stp, ISO7720FDWR.PcbLib, ISO7720FDWR.SchLib, ISO7721FDWR.PcbLib, ISO7721FDWR.SchLib]
2026-03-08 feat: add ferrite bead filtering to charger IC input
    [mcu.SchDoc, opm.PrjPcb, power_mgmt.SchDoc]
2026-03-08 feat: prelim design for MCU
    [OPM.SchDoc, analog_frontend.SchDoc, interface.SchDoc, mcu.SchDoc, opm.PrjPcb, power_mgmt.SchDoc]
2026-03-08 feat: top level reorganization of sheets
    [OPM.SchDoc, battery.SchDoc, charger.SchDoc, mcu.SchDoc, opm.PrjPcb, power_mgmt.SchDoc, regulation.SchDoc]
2026-03-08 feat: prelim design for thermal subsystem
    [OPM.SchDoc, analog_frontend.SchDoc, opm.PrjPcb, thermal.SchDoc]
2026-03-09 feat: add power decoupling + signal filtering to all parts
    [GRM1885C1H103JA01D.PcbLib, GRM1885C1H103JA01D.SchLib, GRM3195C1H104JA05D.PcbLib, GRM3195C1H104JA05D.SchLib, analog_frontend.SchDoc, interface.SchDoc, mcu.SchDoc, opm_lib.PcbLib]
2026-03-09 feat: first round of schematic checks
    [OPM.SchDoc, analog_frontend.SchDoc, battery.SchDoc, charger.SchDoc, interface.SchDoc, mcu.SchDoc, opm.PrjPcb, regulation.SchDoc]
2026-03-10 feat: first round of checks
    - Change AGND, DGND to single system ground
    - Use DCDC converter to isolate USB power from charger IC, thus moving the charger IC and battery to the system side
    - Switch to different TVS diode array to handle D+, D-, and USB power
    [OPM.SchDoc, RFM-0505S.PcbLib, RFM-0505S.SchLib, SP0504BAHTG.PcbLib, SP0504BAHTG.SchLib, analog_frontend.SchDoc, battery.SchDoc, charger.SchDoc]
2026-03-11 feat: second round of checks
    - use separate DRDY pin
    - fix erroneous feedback capacitor values
    - add SWD SWO pin
    - source termination for SPI bus
    -
    [OPM.SchDoc, analog_frontend.SchDoc, battery.SchDoc, charger.SchDoc, interface.SchDoc, mcu.SchDoc, opm_lib.SchLib, regulation.SchDoc]
2026-03-12 feat: create BOM
    - create BOM
    - fix some small issues
    [charger.SchDoc, opm.PrjPcb, opm_lib.SchLib, tia1.SchDoc]
2026-03-12 feat: add designators
    - add component designators
    - fix small issue with power flag
    [OPM.SchDoc, analog_frontend.SchDoc, battery.SchDoc, charger.SchDoc, interface.SchDoc, mcu.SchDoc, opm.PrjPcb, regulation.SchDoc]
2026-03-12 feat: small placement fixes
    [analog_frontend.SchDoc, mcu.SchDoc, tia1.SchDoc]
2026-03-12 feat: configure design rules to prepare for pcb design
    [opm.PcbDoc, opm.PrjPcb, tia1.SchDoc]
2026-03-12 feat: start pcb design
    [opm.PcbDoc]
2026-03-12 feat: r4evert some versions
    [tia1.SchDoc]
2026-03-15 feat: pcb design for analog side + mcu
    - photodiode -> tmux -> TIA paths
    - ADC placement
    - MCU placement
    - Decoupling of ICs
    - thermal subsystem (thermistor)
    [analog_frontend.SchDoc, mcu.SchDoc, opm.PcbDoc, opm.PrjPcb, thermal.SchDoc]
2026-03-15 feat: save document
    [opm.PrjPcb]
2026-03-15 feat: wire isolator, make usb ground
    - wire ISO7721
    - decouple ISO7721
    - make USB ground plane
    [opm.PcbDoc]
2026-03-15 feat: add usb
    [opm.PcbDoc]
2026-03-19 feat: finish pcb
    [OPM.SchDoc, battery.SchDoc, charger.SchDoc, interface.SchDoc, mcu.SchDoc, opm.PcbDoc, opm_lib.PcbLib, opm_lib.SchLib]
2026-03-20 feat: change all analog side decap via traces to 8-10 mil
    reduce trace inductance by shortening decap traces
    [opm.PcbDoc]
2026-03-20 feat: first round of checks
    minor fixes
    [opm.PcbDoc]
2026-03-21 feat: added guard rings and thermal vias
    [opm.PcbDoc, tia1.SchDoc]
2026-03-21 feat: second round of checks and fixes
    [opm.PcbDoc]
2026-03-22 feat: add + check mounting holes + faraday connection, add testpoints
    [opm.PcbDoc]
2026-03-22 feat: check usb wiring and positioning
    [opm.PcbDoc]
2026-03-23 feat: revert usb positioning
    [opm.PcbDoc]
2026-03-23 feat: update guard ring to increase spacing
    fml
    [opm.PcbDoc]
2026-03-24 feat: third round of checks
    [opm.PcbDoc]
2026-03-24 feat: fix silkscreen-copper overlaps
    [opm.PcbDoc, opm.PrjPcb]
2026-03-24 feat: update pcb
    [opm.PrjPcb]
2026-03-25 feat: fourth round of checks
    [opm.PcbDoc]
2026-03-25 feat: fifth round of checks
    [opm.PcbDoc]
2026-03-25 feat: fix silkscreen + usb pads to suit manufacturing
    [opm.PcbDoc, opm_lib.PcbLib]
2026-03-25 feat: minor fixes
    [opm.PcbDoc, opm.PrjPcb]
2026-03-25 feat: change NPTHs to mechanical layer for manufacturing
    [opm.PcbDoc, opm.PrjPcb]
2026-03-26 feat: final fixes and sent to manufacturing
    [opm.PcbDoc, opm.PrjPcb]
2026-03-26 feat: remove old kicad files
    [analog_front_end.kicad_sch, data_conversion.kicad_sch, mcu_digital.kicad_sch, opm.kicad_pcb, opm.kicad_sch, power_supply.kicad_sch, usb_interface.kicad_sch]
